amritpati14/mcb_mini/(notices)

Notices in the files:
mcb_mini_v4.4/firmware/pid.h:
MCBMini firmware is free software: you can redistribute it and/or modify
it under the terms of the GNU General Public License as published by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
